jjrobots/B-ROBOT_EVO2/Blockly/brobot/Brobot2.jpg

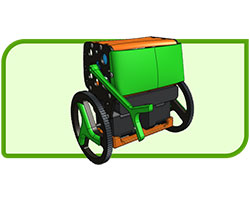
Blockly/brobot/Brobot2.jpg
