jjrobots/B-ROBOT_EVO2/README.md

JJROBOTS B-ROBOT EVO 2
======================
This is the new and improved version of our popular self Balancing Arduino robot. 
Control your robot via Smartphone/Tablet with our app. 3D printed parts.
This new version is more stable, with lot of new features and more fun!

All the documentation, features, how it works, build manuals and SHOP here:
URL: http://www.jjrobots.com/b-robot-evo-2-much-more-than-a-self-balancing-robot/

JJROBOTS 2017. Science & fun!
