jjrobots/B-ROBOT_EVO2/(threads)

Thread 5 (2017-10-11):

[Support Question] Getting the JJRobots app to work with custom code

FHeilmann, 2017-10-11:
Hi JJRobots team,
I recently stumbled upoin the B-Robot EVO 2 and I like the project very much. I wanted to cut down on hardware complexity and also increase processing power to add some new stuff, so I am trying to port the code to directly run on an ESP32 board.

I am struggling with getting data from the JJRobots control app into my code. I set up the WiFi hotspot to the best of my knowledge and, initially, simply set up a UDP listener to show me whether I am receiving something.

I also tested said receiver by sending UDP messages from my android phone to the ESP. Unfortunately, I am unable to intercept messages from the JJRobots control app.

Is there some sort of initialization phase that I need to perform, in order for the app to start sending control data to my ESP? Or does the app not send unless it receives telemetry data from the bot? Could you please tell me which IP address and port the app tries to send data to/receive from?

Thanks a lot for your assistance!

mar0x, 2018-06-29:
Hi @jjrobots team and @FHeilmann,

I'm also interesting in getting the Android app source code.  Although there is an alternative [AndrOSC](https://github.com/ahmetkizilay/AndrOSC), which is looks promising, but does not works for me out of the box (send float numbers as strings).

Technically, B-ROBOT listens UDP 192.168.4.1:2222 and send back to UDP 192.168.4.2:2223.  For communication it uses [OSC](http://opensoundcontrol.org/spec-1_0) protocol. IP addresses is quite easy to change in B-ROBOT sources, but impossible to change in [JJrobots control APP](https://play.google.com/store/apps/details?id=jjrobots.jjrobots_002). This why it would be nice to get the App sources.

There is also [good recap of the current Apps status](http://forums.jjrobots.com/thread-1494.html), but response does not contains the information of Android app sources.

mar0x, 2019-02-12:
Hi @FHeilmann,

Have you get the source code or no longer interested in this project?

FHeilmann, 2019-02-13:
@mar0x no. I have gotten no response and just closed the issue due to inactivity.

Closed 2019-02-12.

Thread 7 (2018-06-11):

Control the robot with the app through wifi

R0muald, 2018-06-11:
Hi,
I just got a Brobot evo2 last week. Once I built it the robot could not stand up (the arm was moving back and forth without doing anything). I connected my phone to the robot and could see the battery level but nothing was working.
I then downloaded the latest code on GitHub and push it to the robot. Then it raised and stabilized like a champ :-). But now the app does not connect at all... I don't see any battery signal nor can control the beast.
- Robot Evo 2 code V2.82
- JJRobots app version 1.28

Is there any compatibility issue with those 2 components that I should be aware of?
Any help/advise would be more than welcome if it's not a known bug.
Thanks.

topherslater, 2021-03-06:
I am having connection problems as well. Broke this bad boy out to build with my son this weekend. Did a full tear down and rebuilt. The SSID shows up in android and IOS, but will not stay connnected (android) will not connect at all (ios iphone8s+) .

Thread 9 (2024-11-17):

Bootloader for Devia Control Board

Belott, 2024-11-17:
Unfortunately, the bootloader on my only remaining Devia Robotics Control board is broken, so I'd like to reflash it. I know how to do that, but I need the right bootloader file.

I've already tried using the file "..\samd\1.8.14\bootloaders\zero\ **samd21_sam_ba.bin** " but that doesn't work, because the Devia Control Board is probably configured a little differently than the Arduino Zero.

I would really appreciate it if someone could tell me where I could find a bootloader file that fits to the Devia Board.
