jjrobots/B-ROBOT_EVO2/Hardware/electronics/brobot19.sch

## EAGLE design Hardware/electronics/brobot19.sch (2017-03-29)

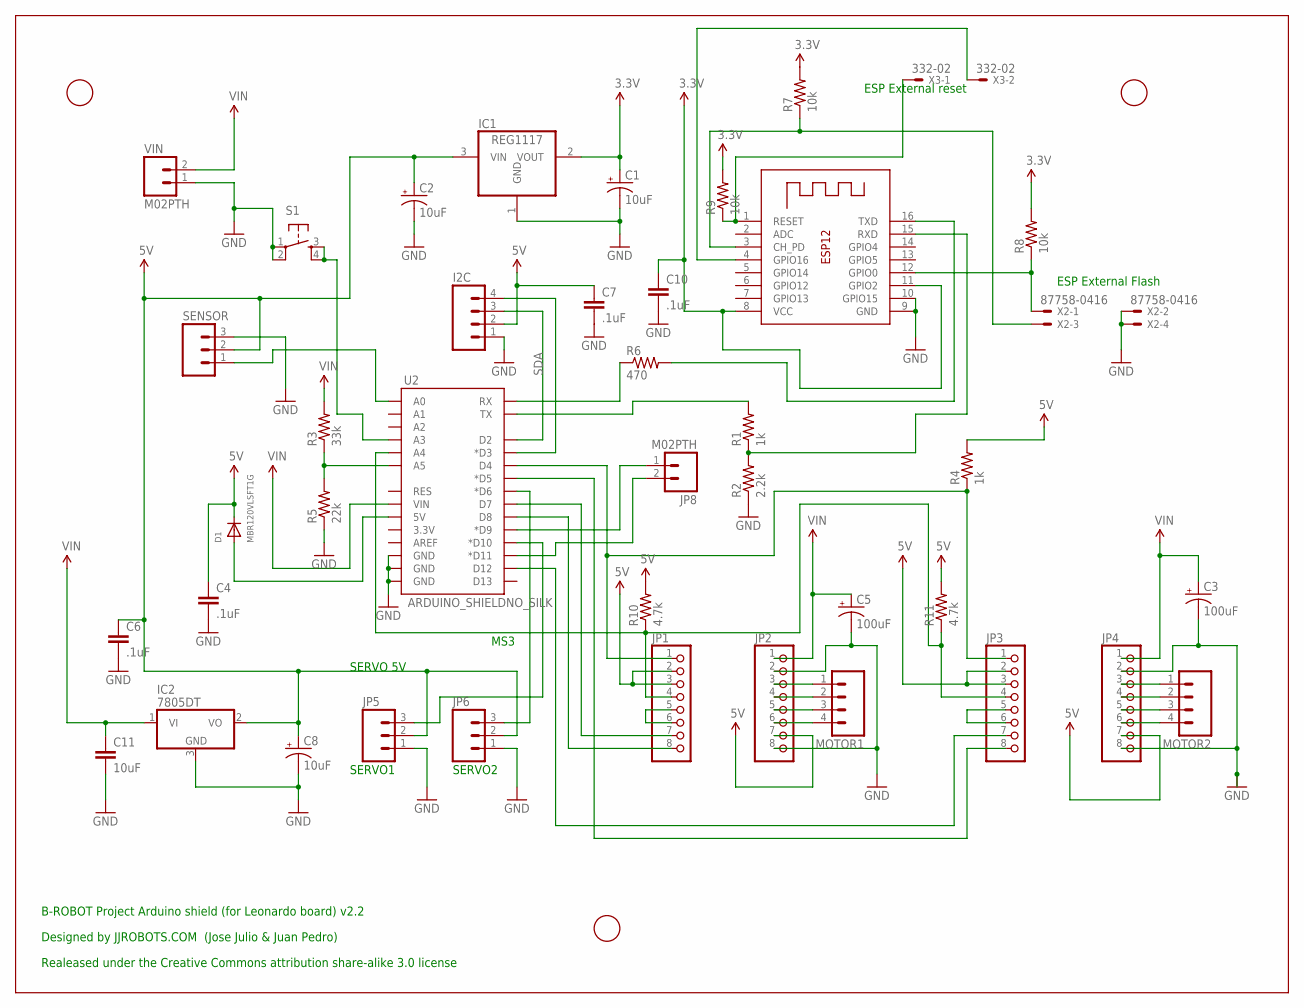
[picture p2: schematic brobot19.sch]

Parts:
C1, C2, C8: 10uF; EIA3216
C3, C5: 100uF; PANASONIC_D
C4, C6, C7, C10: .1uF; 0402-CAP
C11: 10uF; 1206
D1: MBR120VLSFT1G; SOD-123
I2C: M04PTH; 1X04
IC1: REG1117; SOT223
IC2: 7805DT; TO252
JP1, JP2, JP3, JP4: PINHD-1X8; 1X08
JP5, JP6: M03PTH; 1X03
JP8: M02PTH; 1X02
MOTOR1, MOTOR2: M04PTH; 1X04
R1, R4: 1k; 0805
R2: 2.2k; 0805
R3: 33k; 0805
R5: 22k; 0805
R6: 470; 0805
R7, R8, R9: 10k; 0805
R10, R11: 4.7k; 0805
S1: TAC_SWITCHSMD; TACTILE-SWITCH-SMD
SENSOR: M03PTH; 1X03
U2: ARDUINO_SHIELDNO_SILK; DUEMILANOVE_VIAS
U$1, U$2, U$3: FIDUCIAL; FIDUCIAL_1MM
VIN: M02PTH; 1X02
X1: ESP-12
X2: 87758-0416
X3: 332-02

Connections:
3.3V: C1.A (+), C10.1, IC1.2 (VOUT), R7.2, R8.2, R9.2, X1.8 (VCC), X1.11 (GPIO2)
5V: C2.A (+), C4.1, C6.1, C7.1, C8.A (+), D1.C, I2C.2, IC1.3 (VIN), IC2.2 (VO), JP1.2, JP1.3, JP2.7, JP3.2, JP3.3, JP4.7, JP5.2, JP6.2, R4.2, R10.2, R11.2, SENSOR.2
GND: C1.C (-), C2.C (-), C3.-, C4.2, C5.-, C6.2, C7.2, C8.C (-), C10.2, C11.2, I2C.1, IC1.1 (GND), IC2.3 (GND), JP2.2, JP2.8, JP4.2, JP4.8, JP5.1, JP6.1, R2.1, R5.1, S1.1, S1.2, SENSOR.3, U2.GND@0 (GND), U2.GND@1 (GND), U2.GND@2 (GND), VIN.1, X1.9 (GND), X1.10 (GPIO15), X2.2, X2.4
unnamed: JP2.3, MOTOR1.1
unnamed: JP2.4, MOTOR1.2
unnamed: R6.2, X1.16 (TXD)
unnamed: R1.1, R2.2, X1.15 (RXD)
unnamed: R1.2, U2.TX
unnamed: JP2.5, MOTOR1.3
unnamed: JP2.6, MOTOR1.4
unnamed: JP4.3, MOTOR2.1
unnamed: JP4.4, MOTOR2.2
unnamed: JP4.5, MOTOR2.3
unnamed: JP1.5, JP1.6
unnamed: JP3.5, JP3.6
unnamed: R3.1, R5.2, U2.A5
unnamed: R6.1, U2.RX
unnamed: SENSOR.1, U2.A0
unnamed: JP4.6, MOTOR2.4
unnamed: JP6.3, U2.D6 (*D6)
unnamed: R7.1, X1.3 (CH_PD), X2.3
unnamed: JP5.3, U2.D10 (*D10)
unnamed: R8.1, X1.12 (GPIO0), X2.1
unnamed: JP1.8, U2.D8
unnamed: JP1.7, U2.D7
unnamed: JP1.1, JP3.1, R4.1, U2.D4
unnamed: JP3.8, U2.D5 (*D5)
unnamed: JP3.7, U2.D12
unnamed: D1.A, U2.5V
unnamed: JP8.1, U2.D9 (*D9)
unnamed: JP8.2, U2.D11 (*D11)
unnamed: R9.1, X1.1 (RESET), X3.1
unnamed: X1.4 (GPIO16), X3.2
unnamed: JP1.4, JP3.4, R10.1, R11.1, U2.A4
unnamed: S1.3, S1.4, U2.A3
SCL: I2C.4, U2.D3 (*D3)
SDA: I2C.3, U2.D2
VIN: C3.+, C5.+, C11.1, IC2.1 (VI), JP2.1, JP4.1, R3.2, U2.VIN, VIN.2

Notes on the sheet:
SERVO 5V
B-ROBOT Project Arduino shield (for Leonardo board) v2.2
Designed by JJROBOTS.COM (Jose Julio & Juan Pedro)
Realeased under the Creative Commons attribution share-alike 3.0 license
ESP External reset
ESP External Flash
SERVO1
SERVO2
MS3
