jjrobots/B-ROBOT_EVO2/(commit log)

2017-03-29 B-ROBOT EVO2
    First upload: code, electronics...
    [brobot19.sch]
2017-05-06 Bug correction
    Updated version (bug on protocol initialization)
    [BROBOT_EVO2.ino, MPU6050.ino, OSC.ino]
